stevexenios/TreePower/Misc Files/Presentation1.pptx

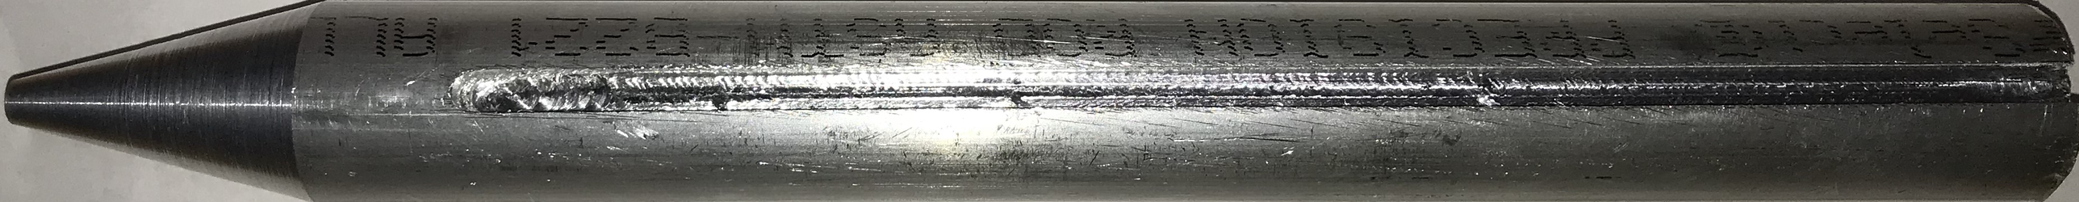
[picture p3: figure]
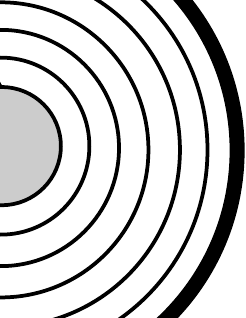
[picture p4: figure]

+
