stevexenios/TreePower/Misc Files/idea2.jpg

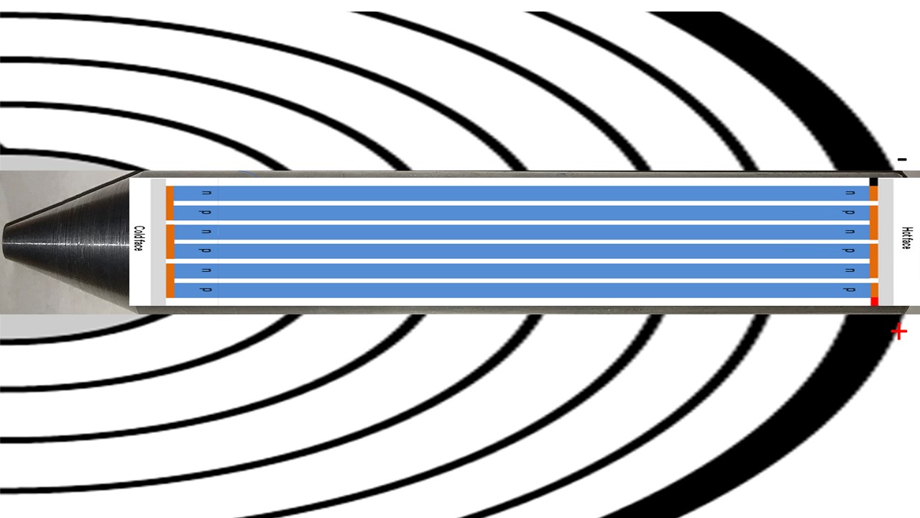
Misc Files/idea2.jpg
