stevexenios/TreePower/Misc Files/Projects.url.jpg

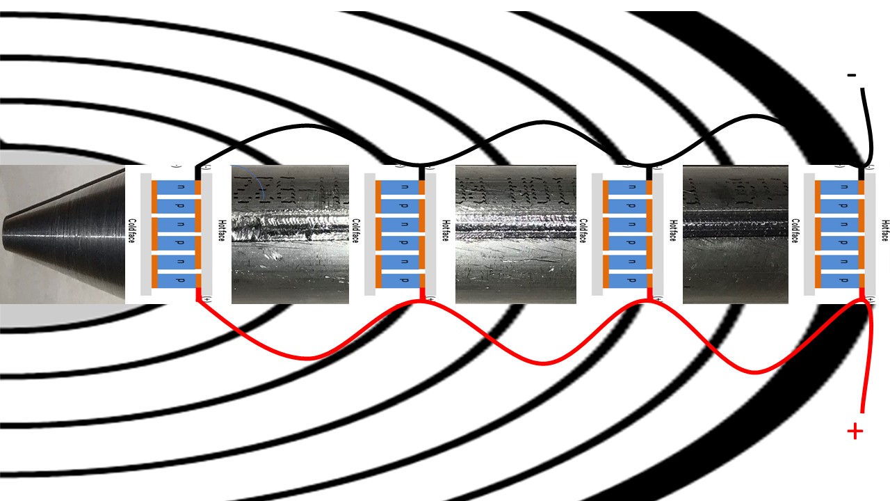
Misc Files/Projects.url.jpg
