stevexenios/TreePower/Pics/58335705034__45D44AAA-7878-4AA2-B2C0-D569AC8305C7.JPG

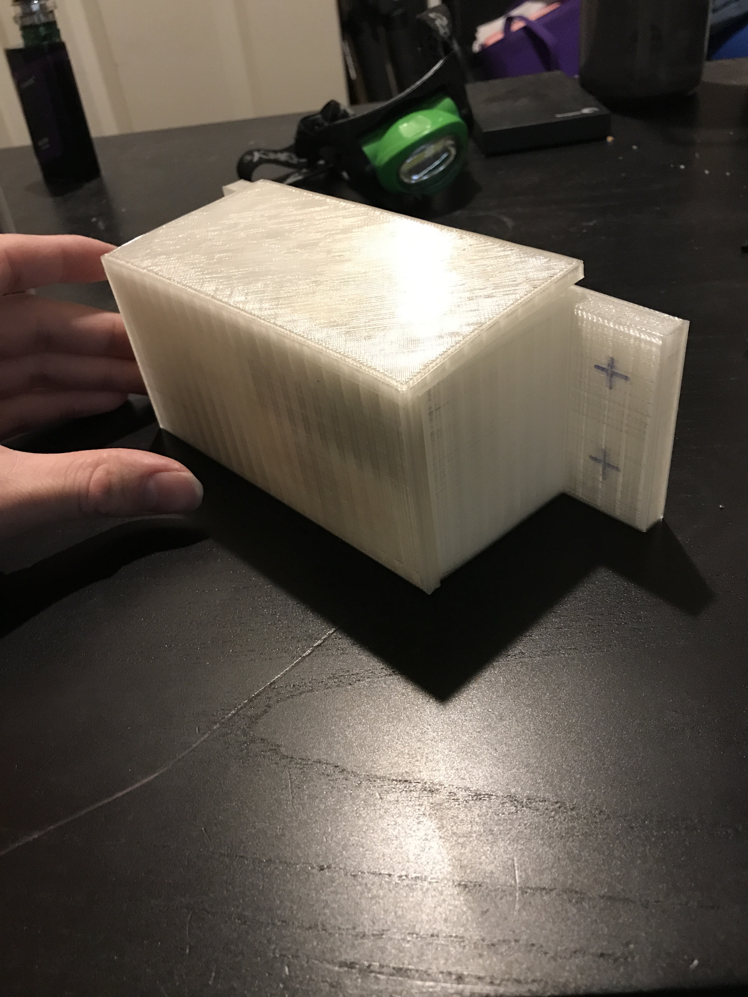
Pics/58335705034__45D44AAA-7878-4AA2-B2C0-D569AC8305C7.JPG
