stevexenios/TreePower/Pics/58335706449__F799D890-3CBF-4869-88B8-931E87948BA6.JPG

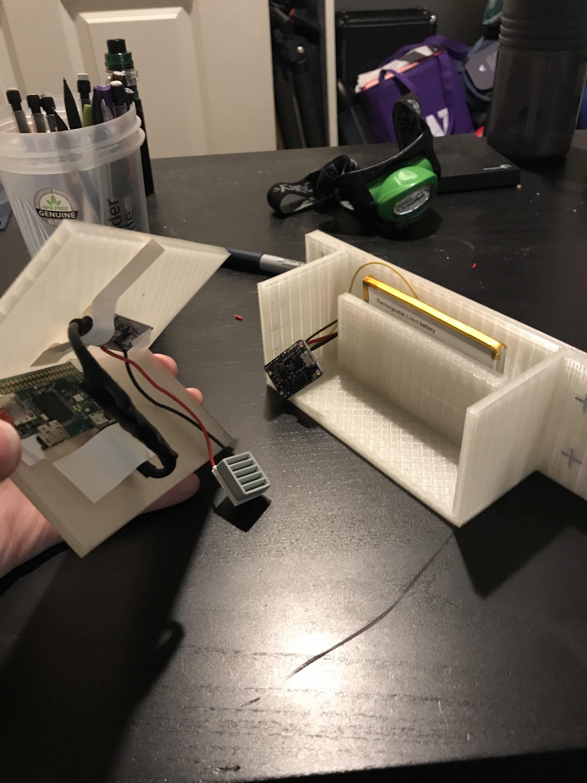
Pics/58335706449__F799D890-3CBF-4869-88B8-931E87948BA6.JPG
