stevexenios/TreePower/Pics/IMG_2349.jpg

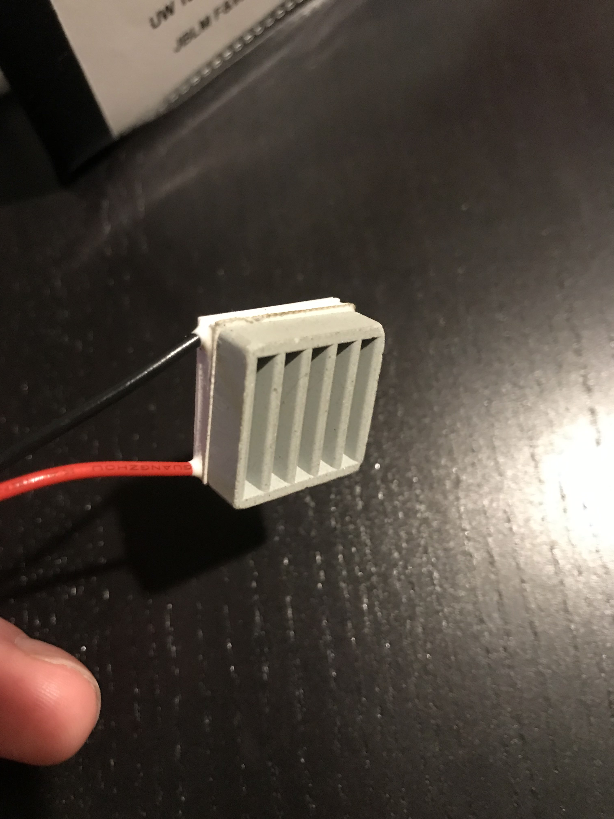
Pics/IMG_2349.jpg
