stevexenios/TreePower/Pics/IMG_2350.jpg

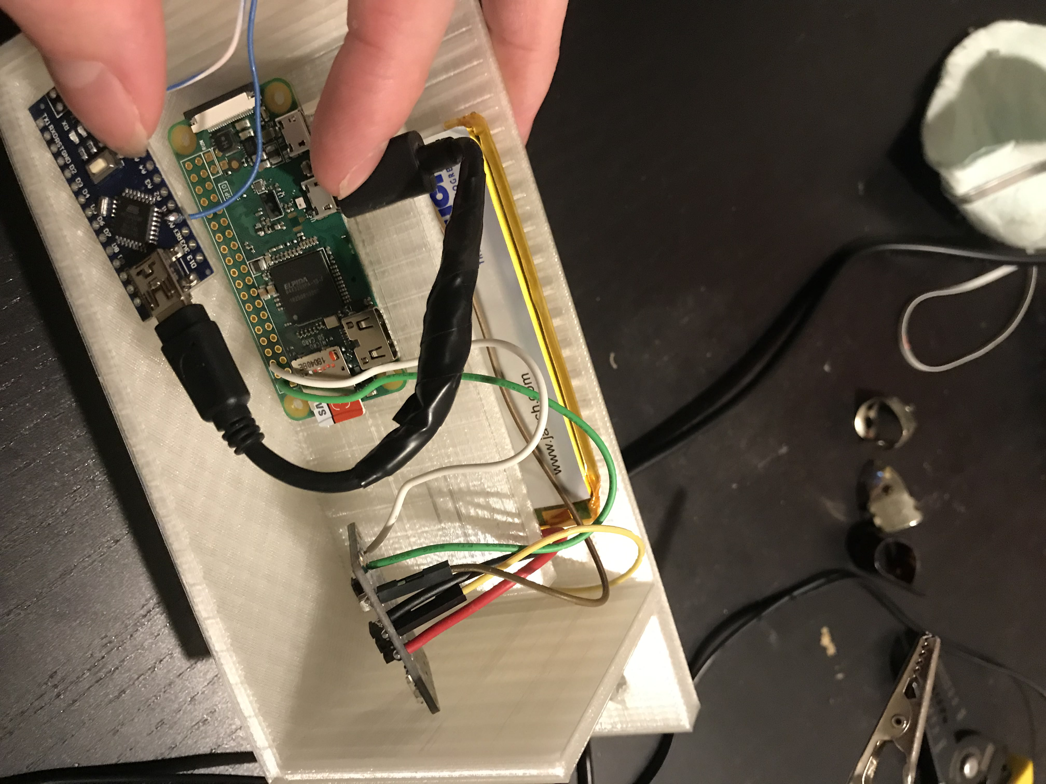
Pics/IMG_2350.jpg
