stevexenios/TreePower/Pics/IMG_2351.jpg

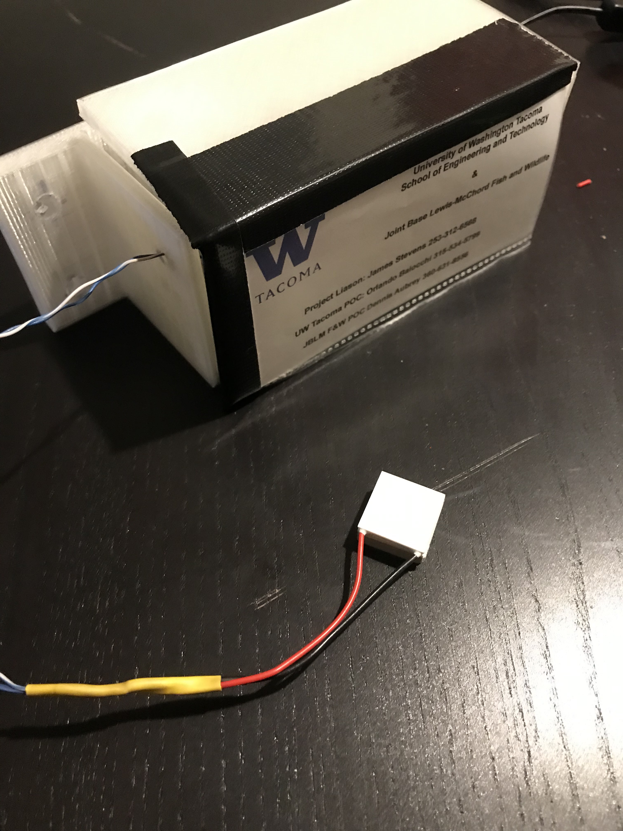
Pics/IMG_2351.jpg
