stevexenios/TreePower/Pics/IMG_2352.jpg

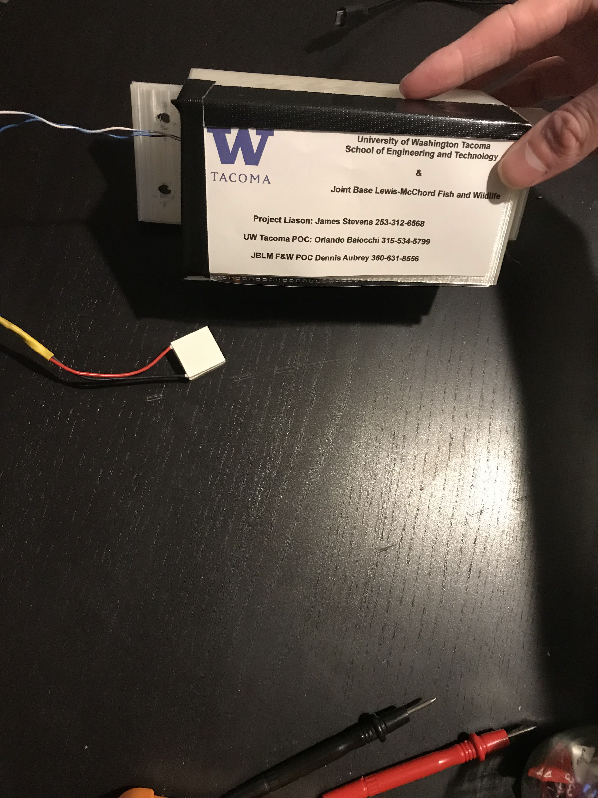
Pics/IMG_2352.jpg
