stevexenios/TreePower/Pics/IMG_2353.jpg

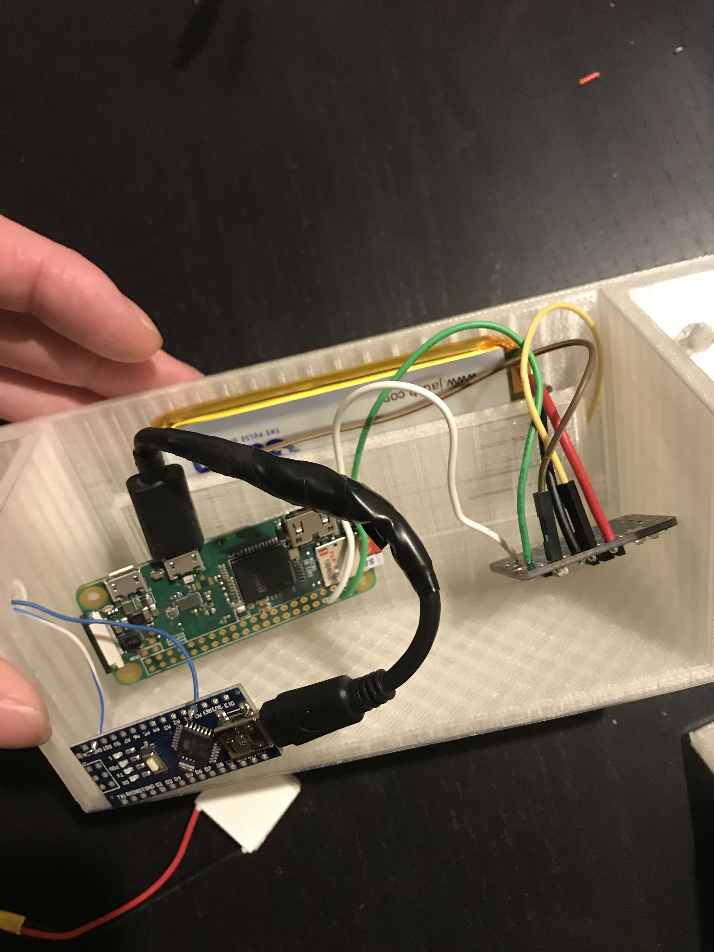
Pics/IMG_2353.jpg
