stevexenios/TreePower/Pics/IMG_2354.jpg

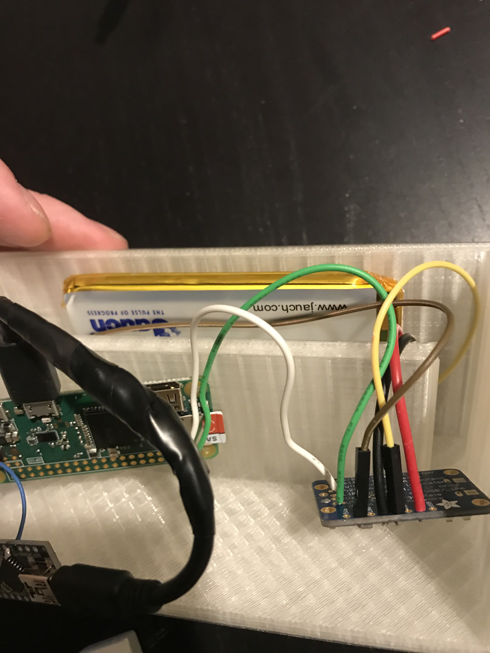
Pics/IMG_2354.jpg
