stevexenios/TreePower/Pics/IMG_2362.jpg

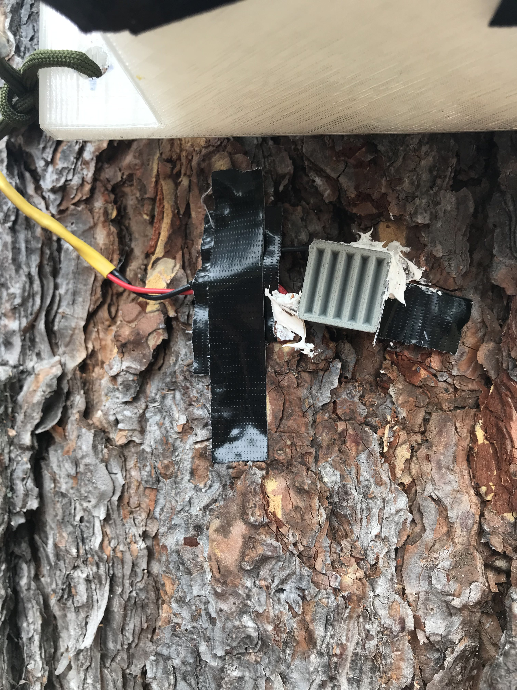
Pics/IMG_2362.jpg
