stevexenios/TreePower/Pics/IMG_2376.jpg

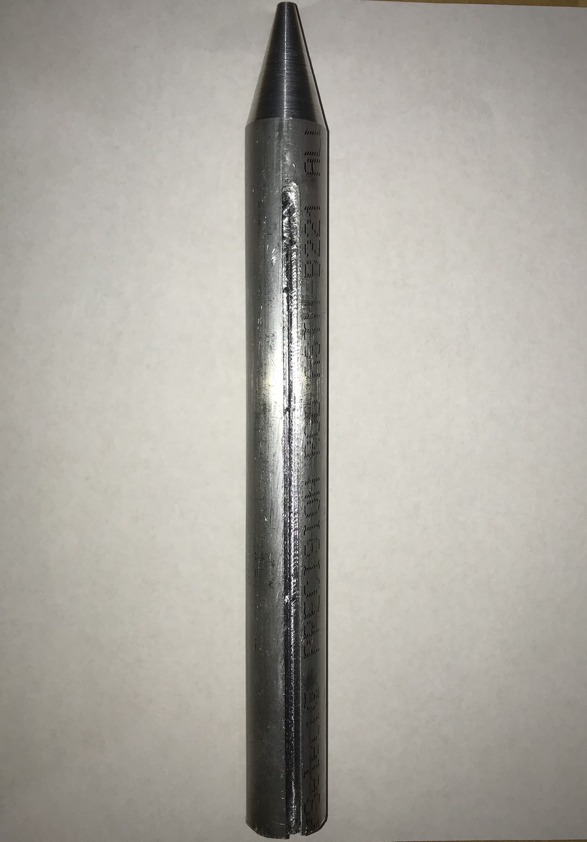
Pics/IMG_2376.jpg
