stevexenios/TreePower/Pics/IMG_2377.jpg

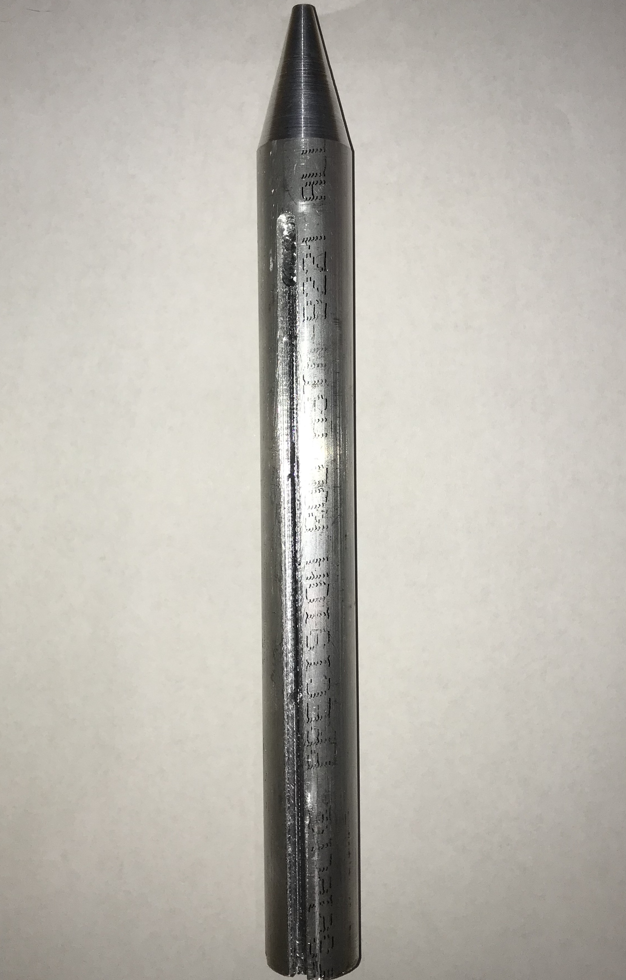
Pics/IMG_2377.jpg
