stevexenios/TreePower/Pics/IMG_2378.jpg

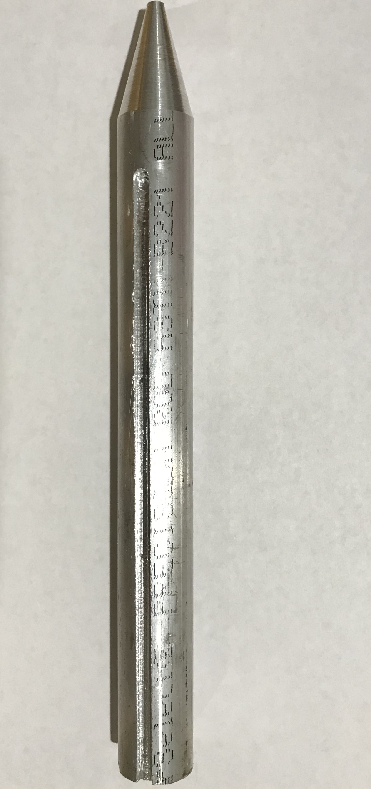
Pics/IMG_2378.jpg
