stevexenios/TreePower/Pics/IMG_2496.jpg

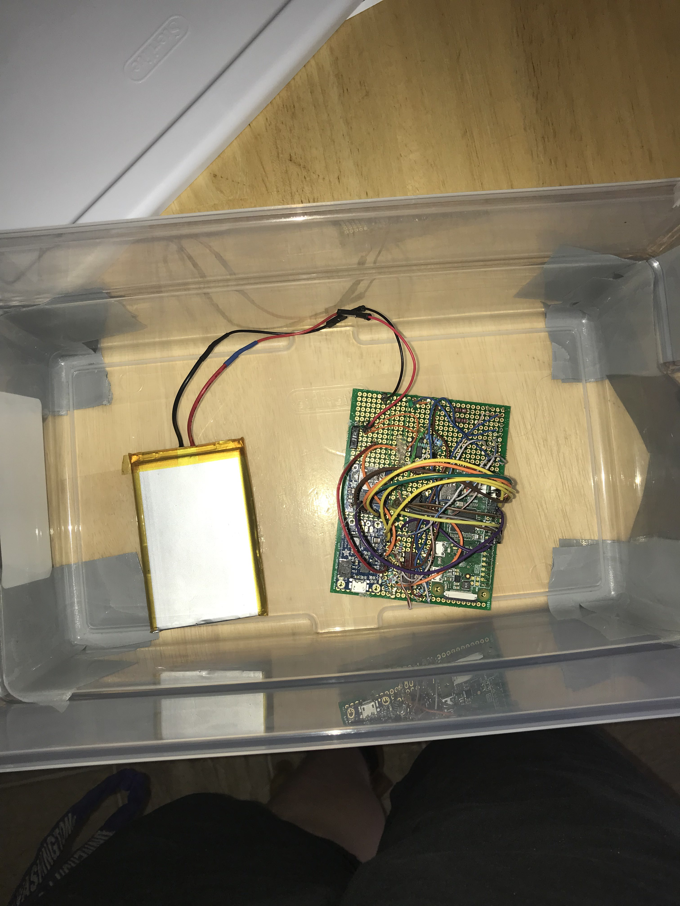
Pics/IMG_2496.jpg
