stevexenios/TreePower/Pics/IMG_2499.jpg

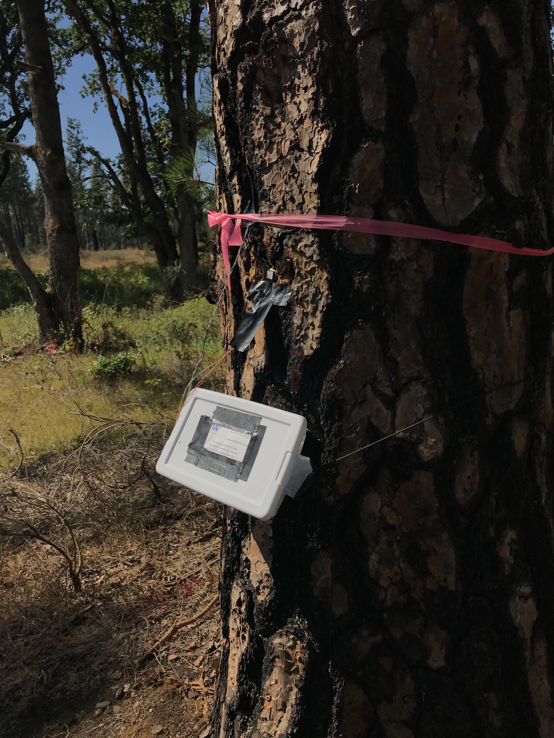
Pics/IMG_2499.jpg
