stevexenios/TreePower/Pics/IMG_2501.jpg

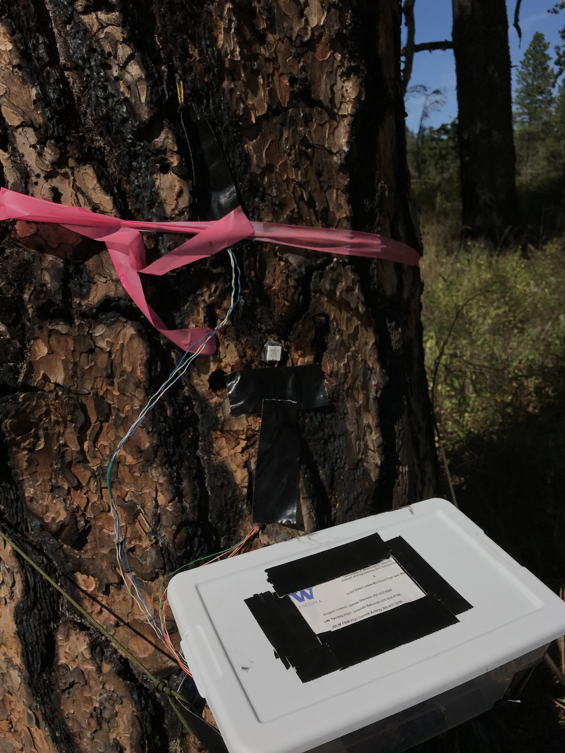
Pics/IMG_2501.jpg
