stevexenios/TreePower/Pics/IMG_2502.jpg

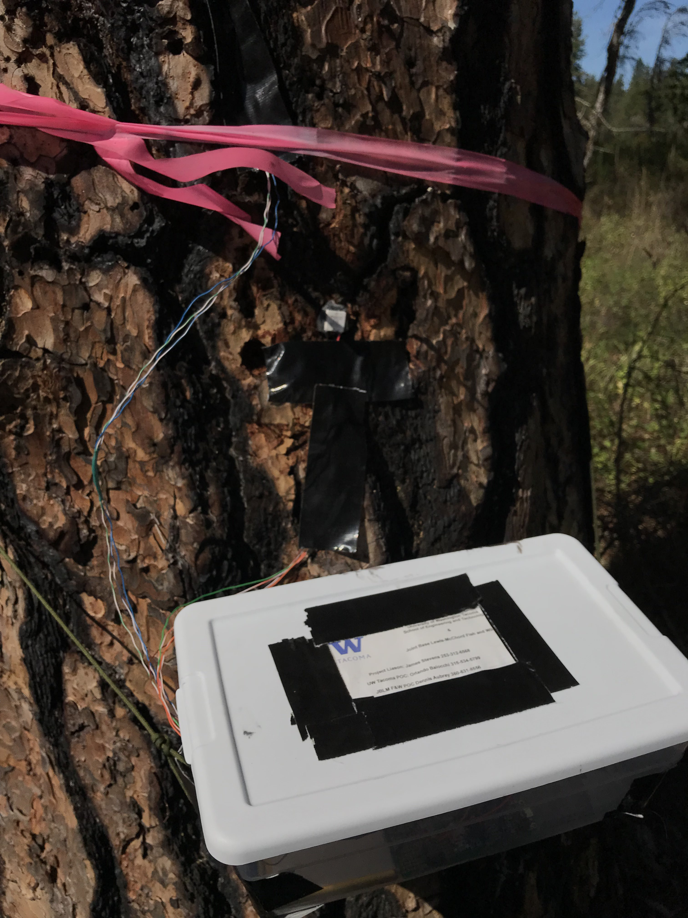
Pics/IMG_2502.jpg
