stevexenios/TreePower/Pics/IMG_2503.jpg

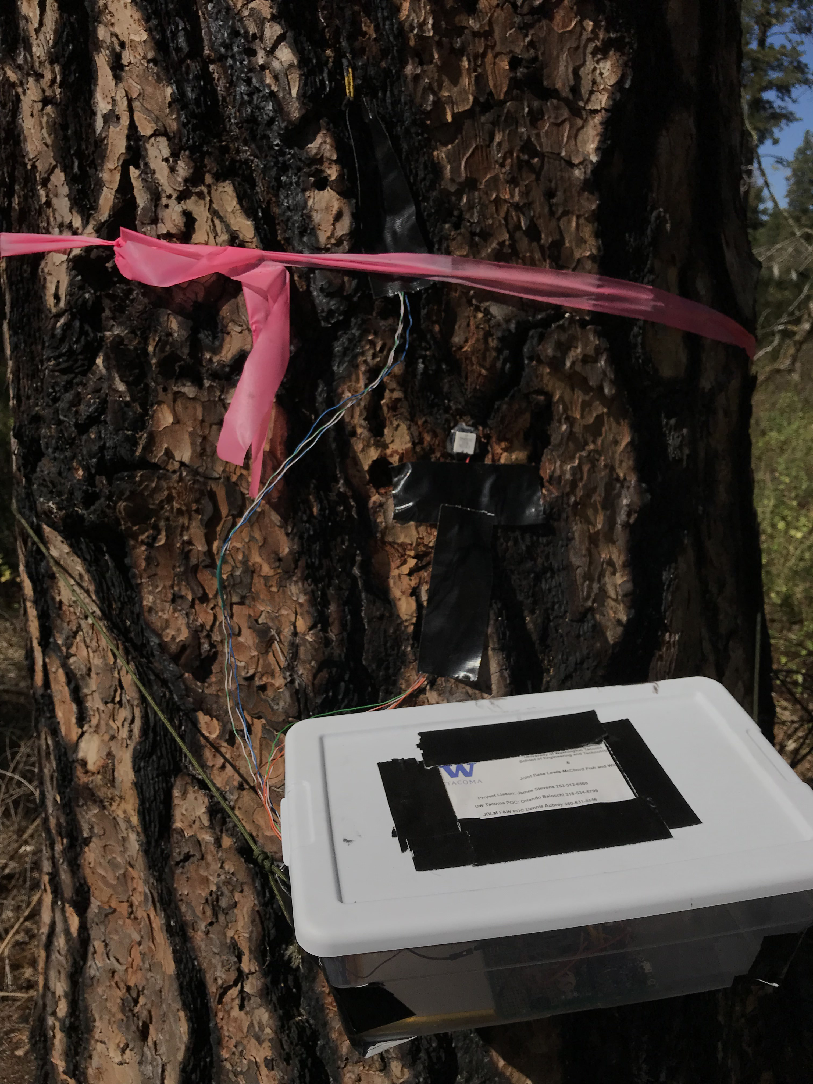
Pics/IMG_2503.jpg
