stevexenios/TreePower/Experiment2/Experiment 2 Parts List.xlsx

Name | Quantity | Price/Unit | Link to Purchase | Datasheet
47uF Cap | 3 | $0.45 | https://www.digikey.com/product-detail/en/UMV0J470MFD1TP/493-10307-1-ND/4312566 | http://nichicon-us.com/english/products/pdfs/e-umv.pdf
.012uF Cap | 3 | $0.32 | https://www.digikey.com/product-detail/en/kemet/C322C123K5R5TA/399-9799-ND/3726016 | https://www.digikey.com/product-detail/en/kemet/C322C123K5R5TA/399-9799-ND/3726016
24MOhm | 3 | $0.62 | https://www.digikey.com/product-detail/en/stackpole-electronics-inc/HVA05FA25M0/HVA05FA25M0CT-ND/6195867 | https://www.seielect.com/catalog/sei-hva.pdf
4MOhm | 3 | $0.54 | https://www.digikey.com/product-detail/en/vishay-bc-components/HVR3700004024FR500/PPCHF4.02MCT-ND/720047 | http://www.vishay.com/docs/30260/hvr2537.pdf
1Ohm | 12 | $0.21 | https://www.digikey.com/product-detail/en/vishay-bc-components/SFR25H0001008FR500/BC4398CT-ND/7351828 | http://www.vishay.com/docs/28722/sfr16s25.pdf
39kOhm | 12 | $0.10 | https://www.digikey.com/product-detail/en/stackpole-electronics-inc/RNF14FTD39K2/RNF14FTD39K2CT-ND/1975133 | https://www.seielect.com/catalog/sei-rnf_rnmf.pdf
40.2KOhm | 12 | $0.10 | https://www.digikey.com/product-detail/en/yageo/MFR-25FBF52-40K2/40.2KXBK-ND/13396
1kOhm | 24 | $0.10 | https://www.digikey.com/product-detail/en/stackpole-electronics-inc/RNF14FTD1K00/RNF14FTD1K00CT-ND/1975018 | https://www.seielect.com/catalog/sei-rnf_rnmf.pdf
7555 Timer | 3 | $0.83 | https://www.digikey.com/product-detail/en/renesas-electronics-america-inc/ICM7555IPAZ/ICM7555IPAZ-ND/821488 | https://www.renesas.com/us/en/www/doc/datasheet/icm7555-56.pdf
RTC Module | 1 | $4.95 | https://www.adafruit.com/product/3295 | https://learn.adafruit.com/adding-a-real-time-clock-to-raspberry-pi?view=all
LM35 (Better Package) | 15 | $2.01 | https://www.digikey.com/product-detail/en/texas-instruments/LM35DZ-LFT1/296-35151-1-ND/3640792 | http://www.ti.com/general/docs/suppproductinfo.tsp?distId=10
15mm TEG | 2 | $15.80 | https://www.digikey.com/product-detail/en/CP60133/102-1672-ND/1747364 | https://www.cui.com/product/resource/cp60.pdf
8 Channel ADC | 2 | $3.75 | https://www.adafruit.com/product/856 | https://learn.adafruit.com/mcp3008-spi-adc/python-circuitpython
MAX44241 OpAmp | 8 | $1.69 | https://www.digikey.com/product-detail/en/MAX44241AUA%2b/MAX44241AUA%2b-ND/4438073?so=59708903 | https://datasheets.maximintegrated.com/en/ds/MAX44241-MAX44246.pdf
Adapter | 8 | $3.19 | https://www.digikey.com/product-detail/en/PA0032/PA0032-ND/5014735?so=59708903 | http://www.chipquik.com/datasheets/PA0032.pdf
Veroboard | 1 | $10.49 | https://www.digikey.com/product-detail/en/chip-quik-inc/SBBTH3040-1/SBBTH3040-1-ND/5978254 | http://www.chipquik.com/datasheets/SBBTH3040-1.pdf
Total |  | $139.33
66uA | 3.7V
