stevexenios/TreePower/Misc Files/base_thermo v2.step

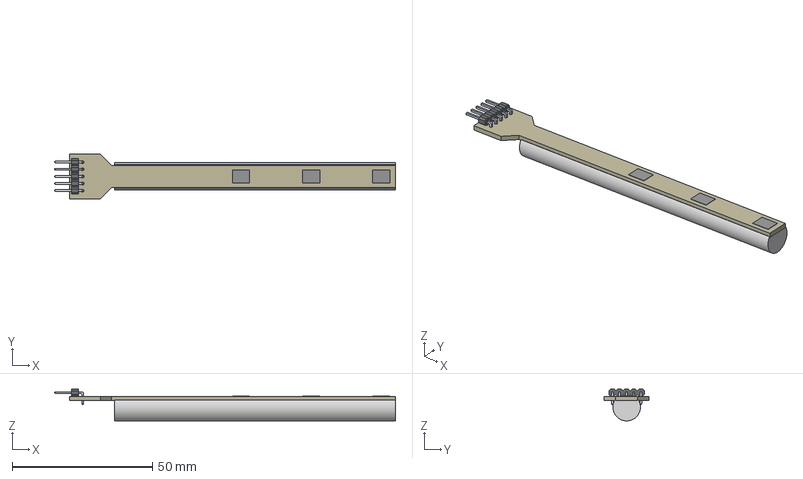
[picture p40: CAD file, 2019-07-12]
Misc Files/base_thermo v2.step
121.4 x 16.0 x 11.3 mm
Board
LM35DM x 3
1X05/90
