stevexenios/TreePower/Experiment1/Exp1.xlsx

Sheet: Sheet1
Date and Time | TEG Voltage (Open Circuit) | Average Voltage(mV) | Voltage(mV)
2019-07-02 14:49 | 0.00mV | 0 | 0
2019-07-02 14:59 | 0.00mV | 0 | 0
2019-07-02 15:09 | 0.00mV | 0 | 0
2019-07-02 15:19 | 0.00mV | 0 | 0
2019-07-02 15:29 | 0.00mV | 0 | 0
2019-07-02 15:39 | 0.00mV | 0 | 0
2019-07-02 15:49 | 0.00mV | 0 | 0
2019-07-02 15:59 | 0.00mV | 0 | 0
2019-07-02 16:09 | 0.00mV | 0 | 0
2019-07-02 16:19 | 0.00mV | 0 | 0
2019-07-02 16:29 | 0.00mV | 0 | 0
2019-07-02 16:39 | 0.00mV | 0 | 0
2019-07-02 16:49 | 0.00mV | 0 | 0
2019-07-02 16:59 | 0.00mV | 0 | 0
2019-07-02 17:09 | 0.00mV | 0 | 0
2019-07-02 17:19 | 0.00mV | 0 | 0
2019-07-02 17:29 | 0.00mV | 0 | 0
2019-07-02 17:39 | 0.00mV | 0 | 0
2019-07-02 17:49 | 0.00mV | 0 | 0
2019-07-02 17:59 | 0.00mV | 0 | 0
2019-07-02 18:09 | 0.00mV | 0 | 0
2019-07-02 18:19 | 0.00mV | 0 | 0
2019-07-02 18:29 | 0.00mV | 0 | 0
2019-07-02 18:39 | 0.00mV | 0 | 0
2019-07-02 18:49 | 0.00mV | 0 | 0
2019-07-02 18:59 | 0.00mV | 0 | 0
2019-07-02 19:09 | 0.00mV | 0 | 0
2019-07-02 19:19 | 0.00mV | 0 | 0
2019-07-02 19:29 | 0.00mV | 0 | 0
2019-07-02 19:39 | 0.00mV | 0 | 0
2019-07-02 19:49 | 0.00mV | 0 | 0
2019-07-02 20:00 | 0.00mV | 0 | 0
2019-07-02 20:10 | 0.00mV | 0 | 0
2019-07-02 20:20 | 0.00mV | 0 | 0
2019-07-02 20:30 | 0.00mV | 0 | 0
2019-07-02 20:40 | 0.00mV | 0 | 0
2019-07-02 20:50 | 0.00mV | 0 | 0
2019-07-02 21:00 | 0.00mV | 0 | 0
2019-07-02 21:10 | 0.00mV | 0 | 0
2019-07-02 21:20 | 0.00mV | 0 | 0
2019-07-02 21:30 | 0.00mV | 0 | 0
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
2019-07-03 12:32 | 0.00mV | 0 | 0
2019-07-03 12:42 | 0.00mV | 0 | 0
2019-07-03 12:52 | 0.00mV | 0 | 0
2019-07-03 13:02 | 0.00mV | 0 | 0
2019-07-03 13:12 | 0.00mV | 0 | 0
2019-07-03 13:22 | 0.00mV | 0 | 0
2019-07-03 13:32 | 0.00mV | 0 | 0
2019-07-03 13:42 | 0.00mV | 0 | 0

Sheet: Sheet2
Time | TEG Voltage (Open Circuit) | Ambient Temperature
2019-07-06 12:17 | 0.00mV | 64 |  | 0
2019-07-06 12:22 | 0.00mV | 64 |  | 0
2019-07-06 12:27 | 0.00mV |  | #N/A | 0
2019-07-06 12:32 | 0.00mV |  | #N/A | 0
2019-07-06 12:53 | 0.00mV | 64 |  | 0
2019-07-06 12:58 | 0.00mV | 65 |  | 0
2019-07-06 13:08 | 0.00mV | 64 |  | 0
2019-07-06 13:58 | 0.00mV | 65 | 18.33°C | 0
2019-07-06 14:48 | 0.00mV |  | #N/A | 0
2019-07-06 14:52 | 0.00mV |  | #N/A | 0
2019-07-06 14:58 | 0.00mV | 66 | 18.89°C | 0
2019-07-06 15:22 | 0.00mV |  | #N/A | 0
2019-07-06 15:22 | 0.00mV |  | #N/A | 0
2019-07-06 15:27 | 0.00mV |  | #N/A | 0
2019-07-06 15:27 | 0.00mV |  | #N/A | 0
2019-07-06 15:32 | 0.00mV |  | #N/A | 0
2019-07-06 15:32 | 0.00mV |  | #N/A | 0
2019-07-06 15:37 | 0.00mV |  | #N/A | 0
2019-07-06 15:37 | 0.00mV |  | #N/A | 0
2019-07-06 15:42 | 0.00mV |  | #N/A | 0
2019-07-06 15:42 | 0.00mV |  | #N/A | 0
2019-07-06 15:47 | 0.00mV |  | #N/A | 0
2019-07-06 15:47 | 0.00mV |  | #N/A | 0
2019-07-06 15:52 | 0.00mV |  | #N/A | 0
2019-07-06 15:52 | 0.00mV |  | #N/A | 0
2019-07-06 15:57 | 0.00mV |  | #N/A | 0
2019-07-06 15:57 | 0.00mV |  | #N/A | 0
2019-07-06 15:58 | 0.00mV | 67 | 19.44°C | 0
2019-07-06 16:02 | 0.00mV |  | #N/A | 0
2019-07-06 16:02 | 0.00mV |  | #N/A | 0
2019-07-06 16:07 | 0.00mV |  | #N/A | 0
2019-07-06 16:07 | 0.00mV |  | #N/A | 0
2019-07-06 16:12 | 0.00mV |  | #N/A | 0
2019-07-06 16:12 | 0.00mV |  | #N/A | 0
2019-07-06 16:17 | 0.00mV |  | #N/A | 0
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
2019-07-07 11:11 | 0.00mV |  | #N/A | 0
2019-07-07 11:16 | 0.00mV |  | #N/A | 0
2019-07-07 11:16 | 0.00mV |  | #N/A | 0
2019-07-07 11:21 | 0.00mV |  | #N/A | 0
2019-07-07 11:21 | 0.00mV |  | #N/A | 0
2019-07-07 11:26 | 0.00mV |  | #N/A | 0
2019-07-07 11:26 | 0.00mV |  | #N/A | 0
