stevexenios/TreePower/Experiment2/Exp2.xlsx

Sheet: Exp2
T-Rod | T-Ambient | V(-) | V(+) | Ambient-24.7 | Simulated Voltage | Power(-) | Power(+) | Time | Simulated Voltage | Positive mV/C | Negative mV/C
27.393 °C | 41.250 °C | 0.000mV | 2.141mV | 16.550 °C | 4.1375 | 0.000uW | 4.584uW | 2019-08-13 15:38 | 3.310mV | 0.2 | 0.2 | 1.169mV | -3.619 | 6.252344629e-05 |  | 0.0001 | 0.4 | 0.0005607421462 | 0.0001 | 0.0015 | 1.066152056
27.393 °C | 41.250 °C | 0.000mV | 2.141mV | 16.550 °C | 4.1375 | 0.000uW | 4.584uW | 2019-08-13 15:38 | 3.310mV |  |  | 1.169mV | -3.5834 | 6.252344629e-05 |  | 0.0001
27.393 °C | 40.928 °C | 0.000mV | 2.141mV | 16.228 °C | 4.057 | 0.000uW | 4.584uW | 2019-08-13 15:38 | 3.246mV |  |  | 1.105mV | -3.5544 | 6.252344629e-05 |  | 0.0001
27.393 °C | 41.250 °C | 0.000mV | 2.141mV | 16.550 °C | 4.1375 | 0.000uW | 4.584uW | 2019-08-13 15:38 | 3.310mV |  |  | 1.169mV | -3.519 | 0.0001875703389 |  | 0.0001
27.393 °C | 41.250 °C | 0.000mV | 2.049mV | 16.550 °C | 4.1375 | 0.000uW | 4.198uW | 2019-08-13 15:38 | 3.310mV |  |  | 1.261mV | -3.5122 | 0.0001250468926 |  | 0.0001
27.715 °C | 41.572 °C | 0.000mV | 2.141mV | 16.872 °C | 4.218 | 0.000uW | 4.584uW | 2019-08-13 15:38 | 3.374mV |  |  | 1.233mV | -3.4834 | 6.252344629e-05 |  | 0.0001
27.715 °C | 41.250 °C | 0.000mV | 2.141mV | 16.550 °C | 4.1375 | 0.000uW | 4.584uW | 2019-08-13 15:38 | 3.310mV |  |  | 1.169mV | -3.4768 | 6.252344629e-05 |  | 0.0001
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
23.525 °C | 31.904 °C | 0.000mV | 1.701mV | 7.204 °C | 1.801 | 0.000uW | 2.893uW | 2019-08-13 17:26 | 1.441mV |  |  | -0.260mV | -0.4326 | 0.003563836439 |  | 0.0009323344736
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
