stevexenios/TreePower/Experiment1/Test 1 Results.xlsx

Sheet: Sheet2
Date | Time | Voltage(mV) | Average Voltage(mV) | Voltage(mV)
2019-07-02 | 14:39:07 | 0 | 0
2019-07-02 | 14:44:08 | 0 | 0
2019-07-02 | 14:49:09 | 0 | 0 | 0
2019-07-02 | 14:54:10 | 0 | 0
2019-07-02 | 14:59:11 | 0 | 0 | 0
2019-07-02 | 15:04:11 | 0 | 0
2019-07-02 | 15:09:12 | 0 | 0 | 0
2019-07-02 | 15:14:13 | 0 | 0
2019-07-02 | 15:19:13 | 0 | 0 | 0
2019-07-02 | 15:24:15 | 0 | 0
2019-07-02 | 15:29:16 | 0 | 0 | 0
2019-07-02 | 15:34:16 | 0 | 0
2019-07-02 | 15:39:17 | 0 | 0 | 0
2019-07-02 | 15:44:18 | 0 | 0
2019-07-02 | 15:49:18 | 0 | 0 | 0
2019-07-02 | 15:54:20 | 0 | 0
2019-07-02 | 15:59:21 | 0 | 0 | 0
2019-07-02 | 16:04:21 | 0 | 0
2019-07-02 | 16:09:22 | 0 | 0 | 0
2019-07-02 | 16:14:23 | 0 | 0
2019-07-02 | 16:19:23 | 0 | 0 | 0
2019-07-02 | 16:24:25 | 0 | 0
2019-07-02 | 16:29:25 | 0 | 0 | 0
2019-07-02 | 16:34:26 | 0 | 0
2019-07-02 | 16:39:27 | 0 | 0 | 0
2019-07-02 | 16:44:27 | 0 | 0
2019-07-02 | 16:49:28 | 0 | 0 | 0
2019-07-02 | 16:54:30 | 0 | 0
2019-07-02 | 16:59:30 | 0 | 0 | 0
2019-07-02 | 17:04:31 | 0 | 0
2019-07-02 | 17:09:32 | 0 | 0 | 0
2019-07-02 | 17:14:32 | 0 | 0
2019-07-02 | 17:19:33 | 0 | 0 | 0
2019-07-02 | 17:24:35 | 0 | 0
2019-07-02 | 17:29:35 | 0 | 0 | 0
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
