stevexenios/TreePower/Experiment2/AluminumRod.JPG

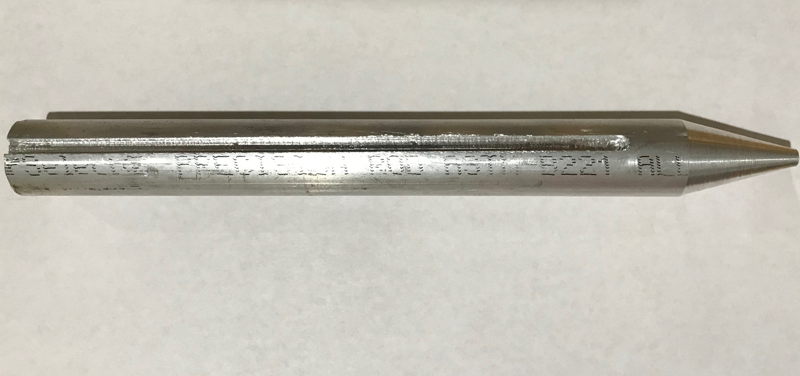
Experiment2/AluminumRod.JPG
