stevexenios/TreePower/Experiment2/7555LTSpice.asc

C1: cap; 47µ
C2: cap; .01µF
D1: diode; 1N914
R1: res; 24Meg
R2: res; 4Meg
U1: NE555
V1: voltage; 3.7
Named nets: 0, Vin
.tran 18000 startup
