stevexenios/TreePower/Experiment2/Schematics/Sense1.sch

## KiCad design Experiment2/Schematics/Sense1.sch (2019-09-02)

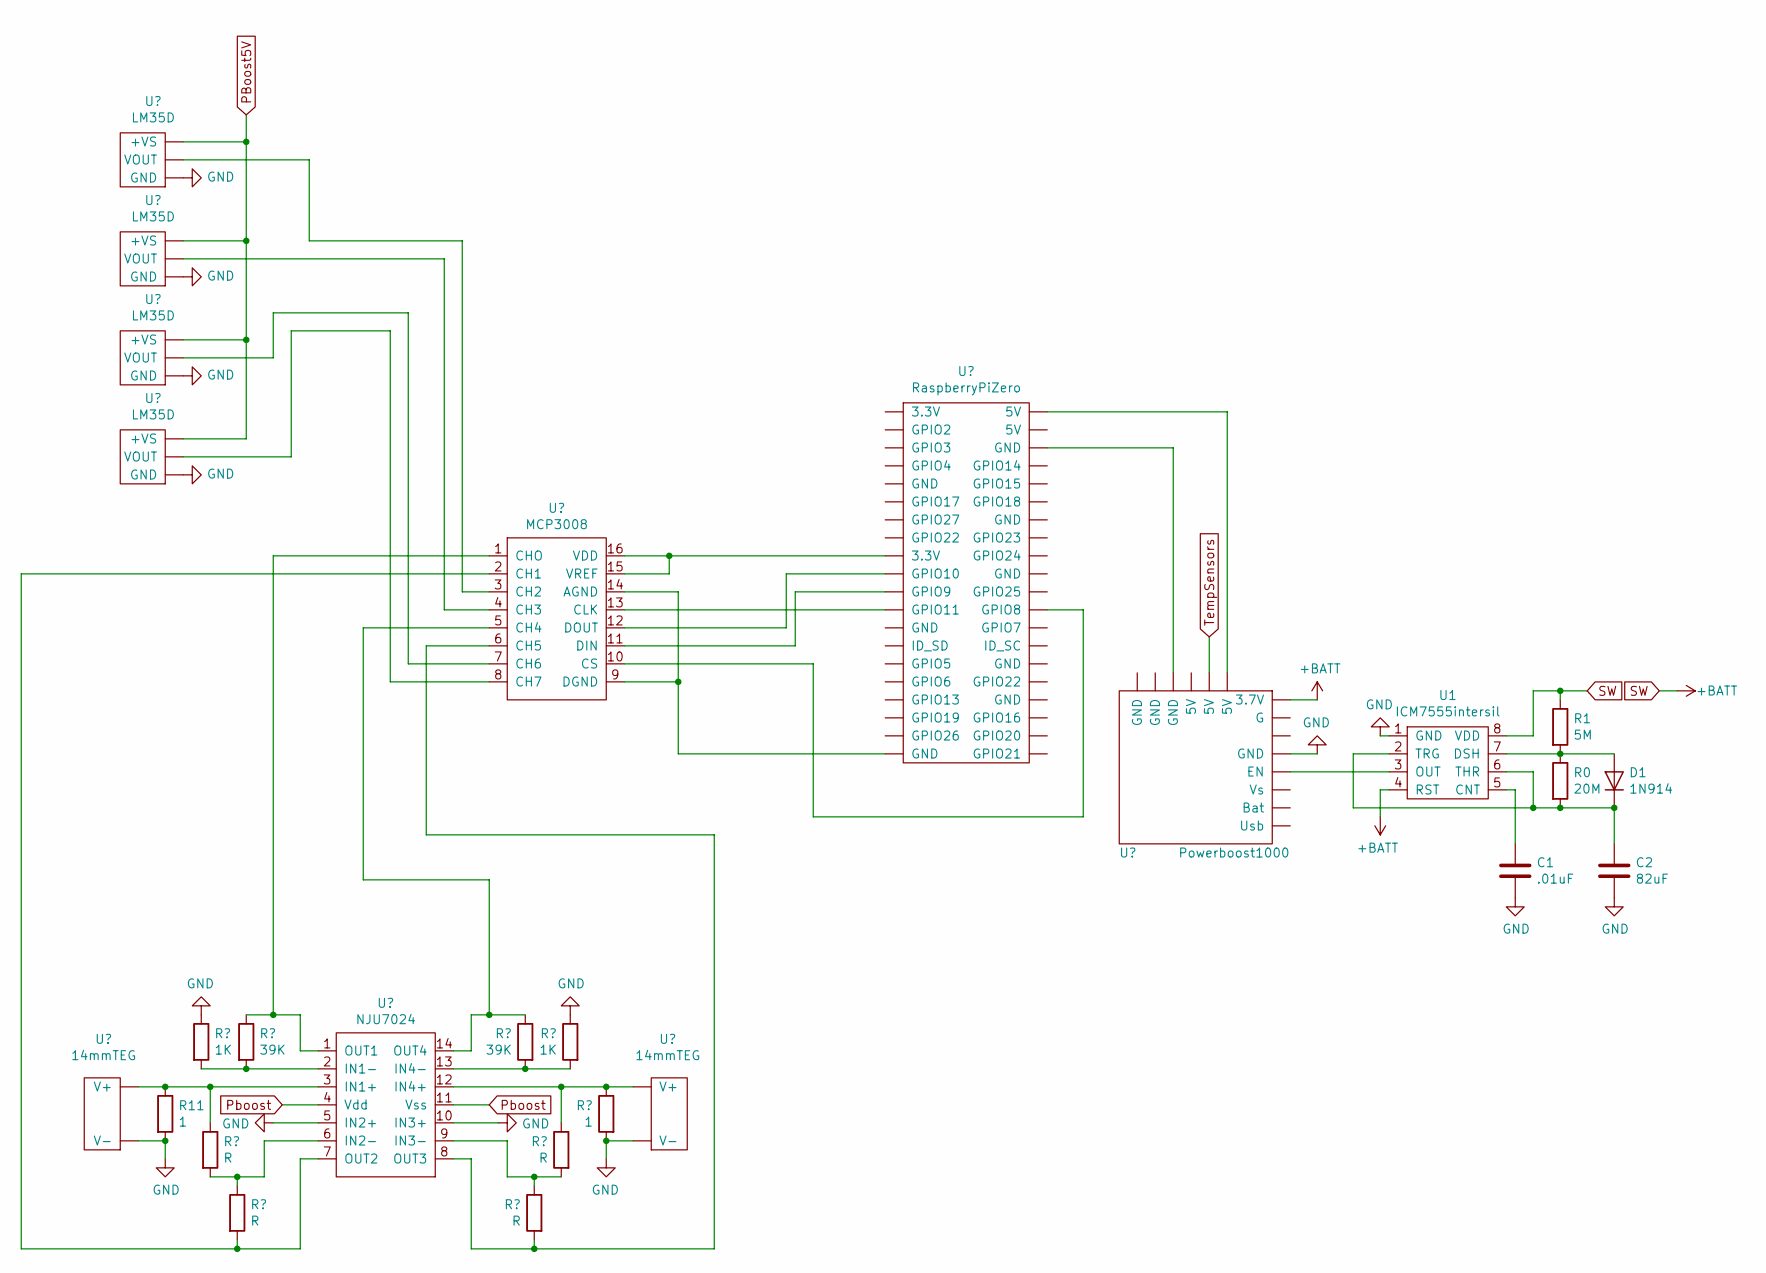
[picture p42: schematic Sense1.sch]

Parts:
C1: .01uF; C_Rect_L7.0mm_W4.5mm_P5.00mm
C2: 82uF; CP_Radial_D5.0mm_P2.50mm
D1: 1N914; D_DO-35_SOD27_P7.62mm_Horizontal
R0: 20M; R_Axial_DIN0309_L9.0mm_D3.2mm_P12.70mm_Horizontal
R1: 5M; R_Axial_DIN0309_L9.0mm_D3.2mm_P12.70mm_Horizontal
R11: 1
U1: ICM7555intersil

Connections:
+BATT: R1.1, U1.4 (RST), U1.8 (VDD)
GND: C1.2, C2.2, R11.2, U1.1 (GND)
unnamed: C1.1, U1.5 (CNT)
unnamed: C2.1, D1.1 (K), R0.2, U1.2 (TRG), U1.6 (THR)
unnamed: D1.2 (A), R0.1, R1.2, U1.7 (DSH)
