stevexenios/TreePower/Experiment2/Schematics/TreePower2.sch

## KiCad design Experiment2/Schematics/TreePower2.sch (2019-09-02)

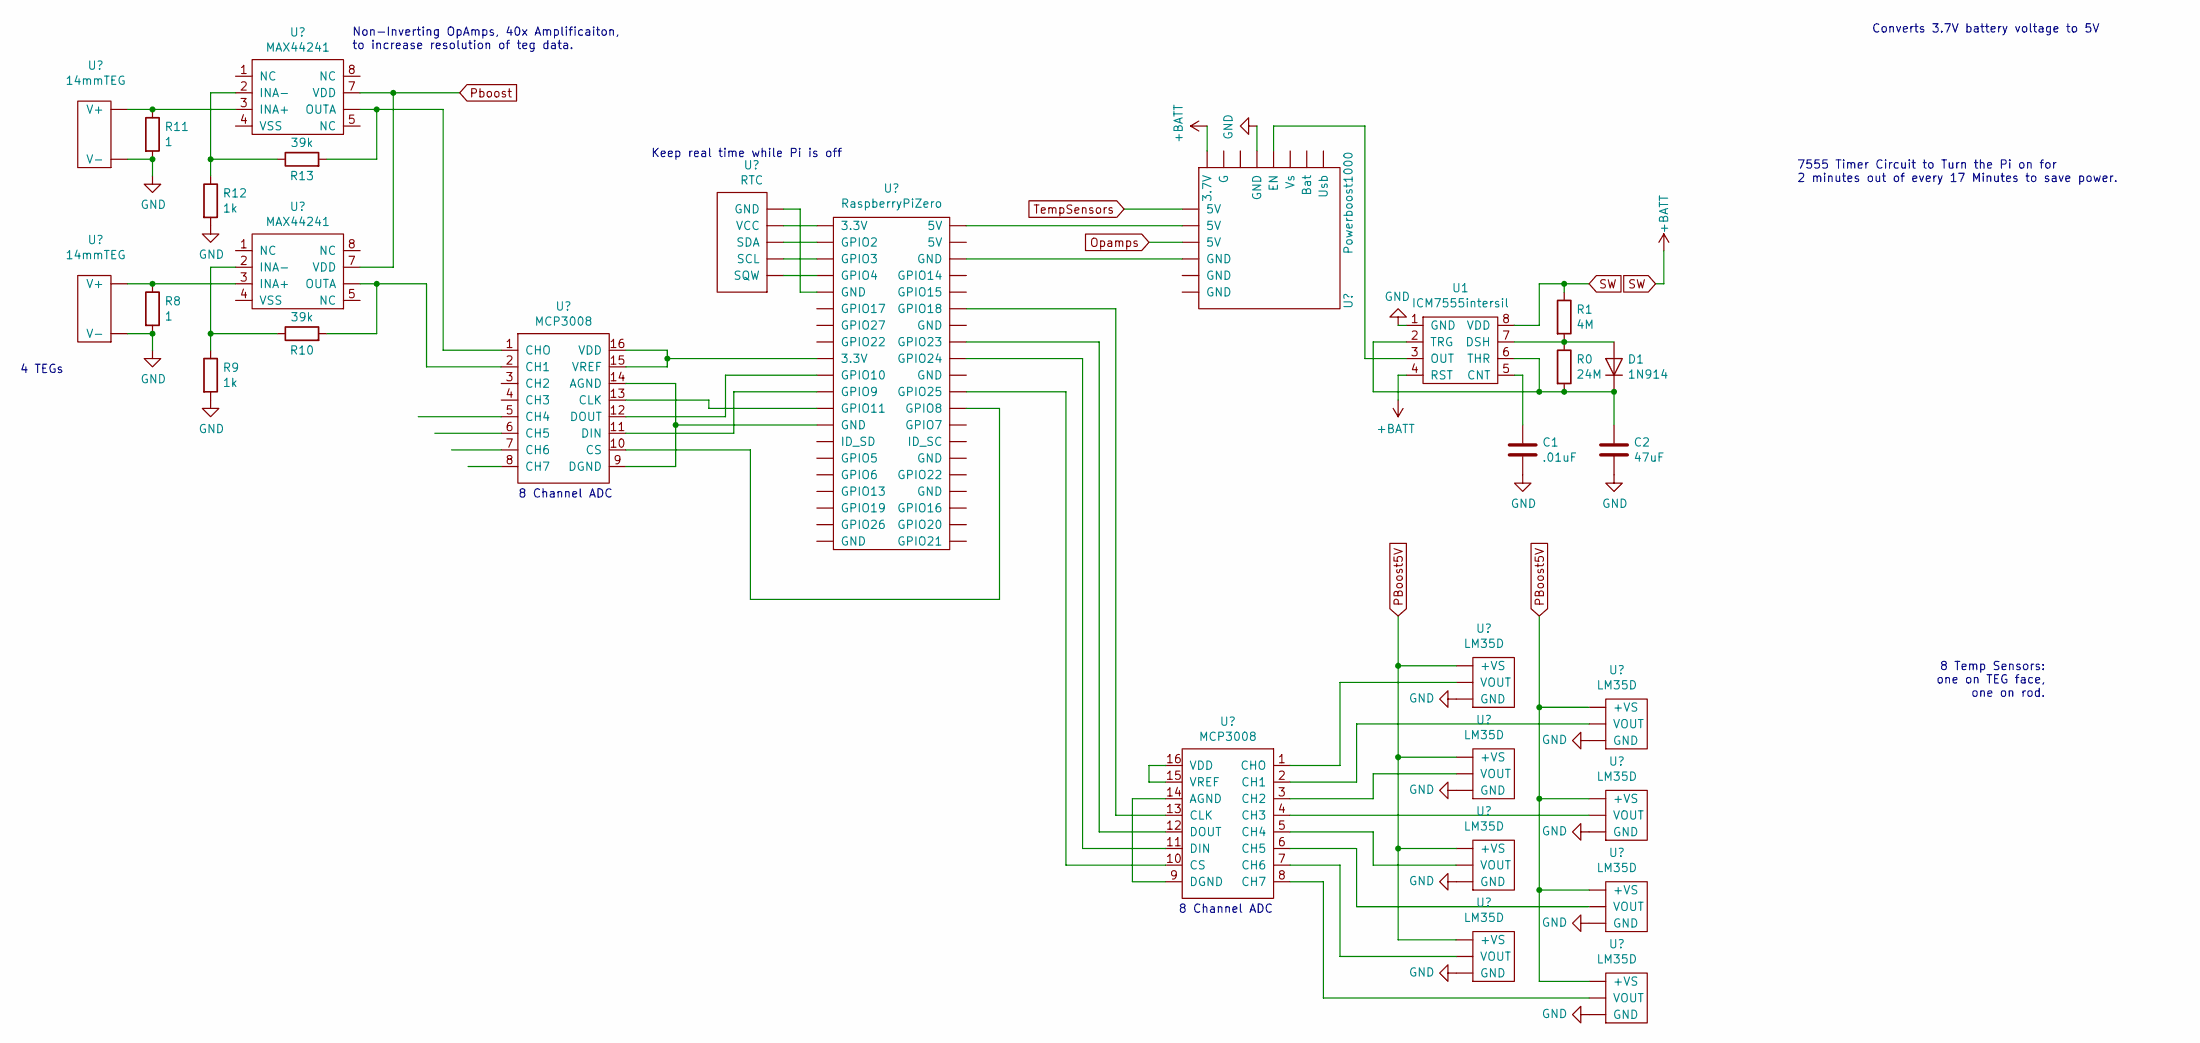
[picture p43: schematic TreePower2.sch]

Parts:
C1: .01uF; C_Rect_L7.0mm_W4.5mm_P5.00mm
C2: 47uF; CP_Radial_D5.0mm_P2.50mm
D1: 1N914; D_DO-35_SOD27_P7.62mm_Horizontal
R0: 24M; R_Axial_DIN0309_L9.0mm_D3.2mm_P12.70mm_Horizontal
R1: 4M; R_Axial_DIN0309_L9.0mm_D3.2mm_P12.70mm_Horizontal
R8, R11: 1
R9, R12: 1k
R10, R13: 39k
U1: ICM7555intersil

Connections:
+BATT: R1.1, U1.4 (RST), U1.8 (VDD)
GND: C1.2, C2.2, R8.2, R9.2, R11.2, R12.2, U1.1 (GND)
unnamed: C1.1, U1.5 (CNT)
unnamed: C2.1, D1.1 (K), R0.2, U1.2 (TRG), U1.6 (THR)
unnamed: D1.2 (A), R0.1, R1.2, U1.7 (DSH)
unnamed: R9.1, R10.1
unnamed: R12.1, R13.1

Notes on the sheet:
Keep real time while Pi is off
8 Channel ADC
4 TEGs
Non-Inverting OpAmps, 40x Amplificaiton, to increase resolution of teg data.
7555 Timer Circuit to Turn the Pi on for 2 minutes out of every 17 Minutes to save power.
Converts 3.7V battery voltage to 5V
8 Temp Sensors: one on TEG face, one on rod.
