stevexenios/TreePower/(commit log)

2019-06-30 Create writevolt.py
    Saves voltage data from arduino on pi
2019-07-06 arduino code
2019-07-12 Schematic for the 2nd Experiment
2019-07-12 misc files
    [base_thermo v2.step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]
2019-09-02 Missing Files
    [Sense1.kicad_pcb, Sense1.sch, TreePower2.sch]
