stevexenios/TreePower/Pics/IMG_2355.jpg

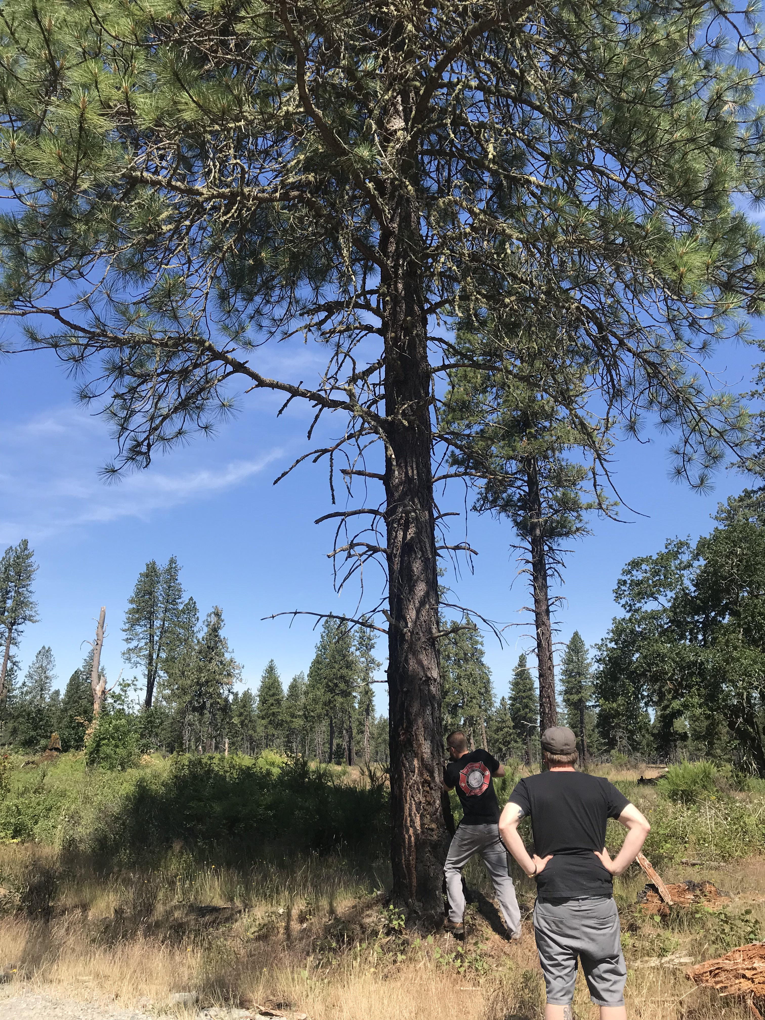
Pics/IMG_2355.jpg
