stevexenios/TreePower/Pics/IMG_2356.jpg

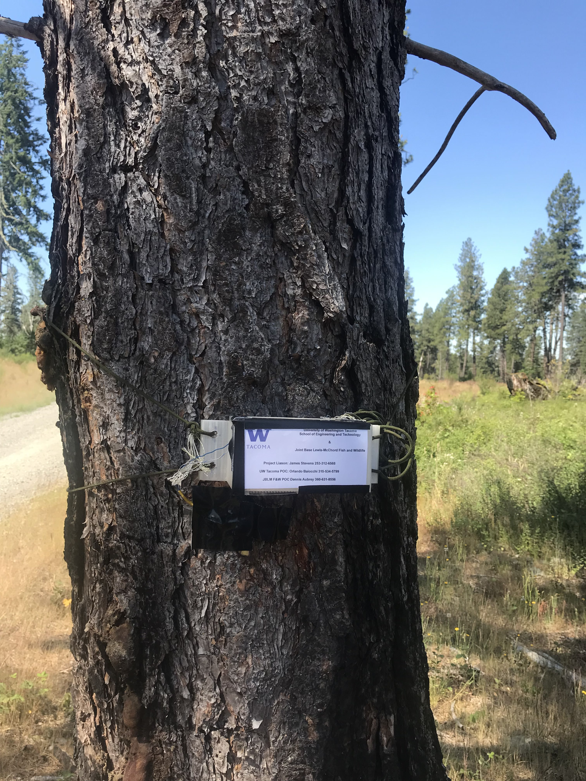
Pics/IMG_2356.jpg
