stevexenios/TreePower/Pics/IMG_2359.jpg

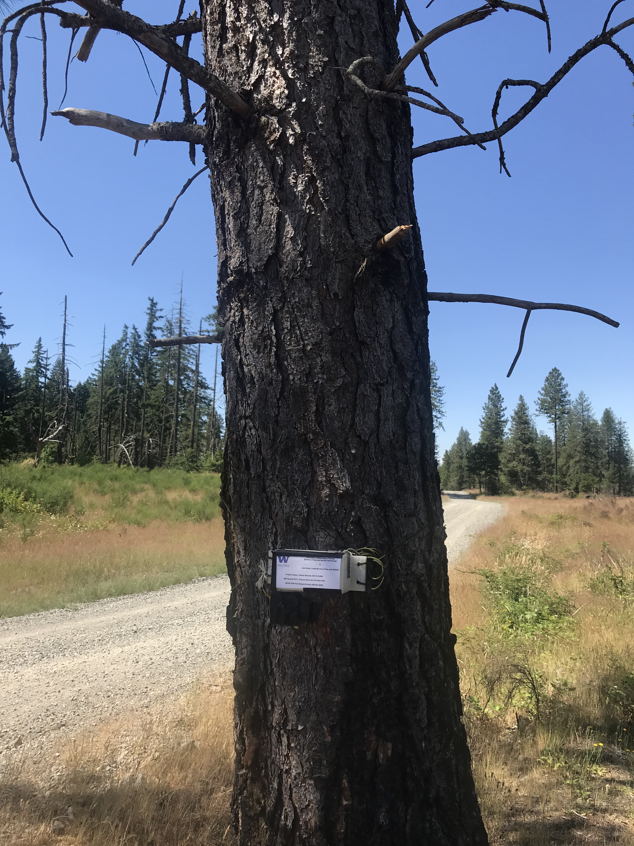
Pics/IMG_2359.jpg
