stevexenios/TreePower/Pics/IMG_2360.jpg

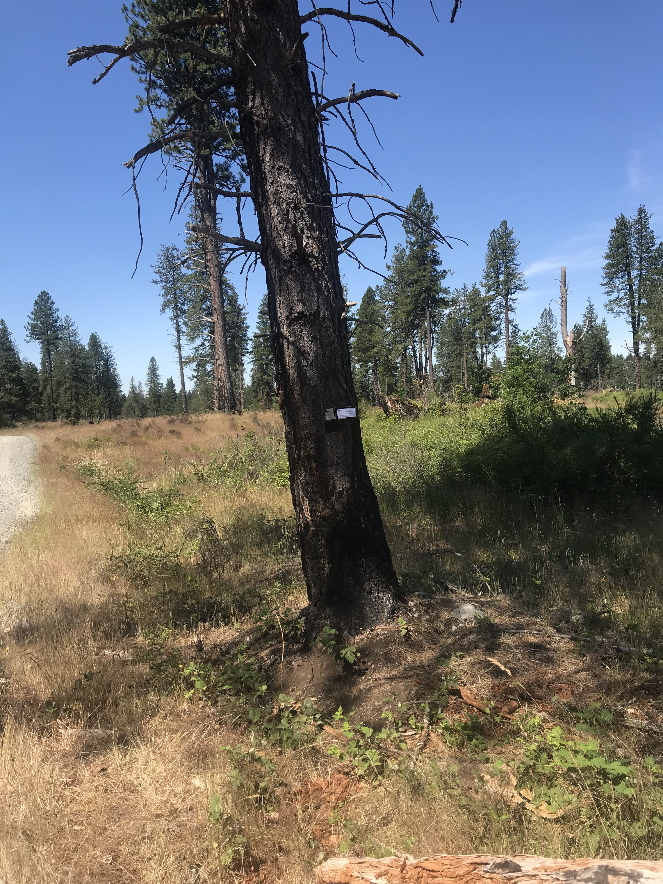
Pics/IMG_2360.jpg
