stevexenios/TreePower/Pics/IMG_2363.jpg

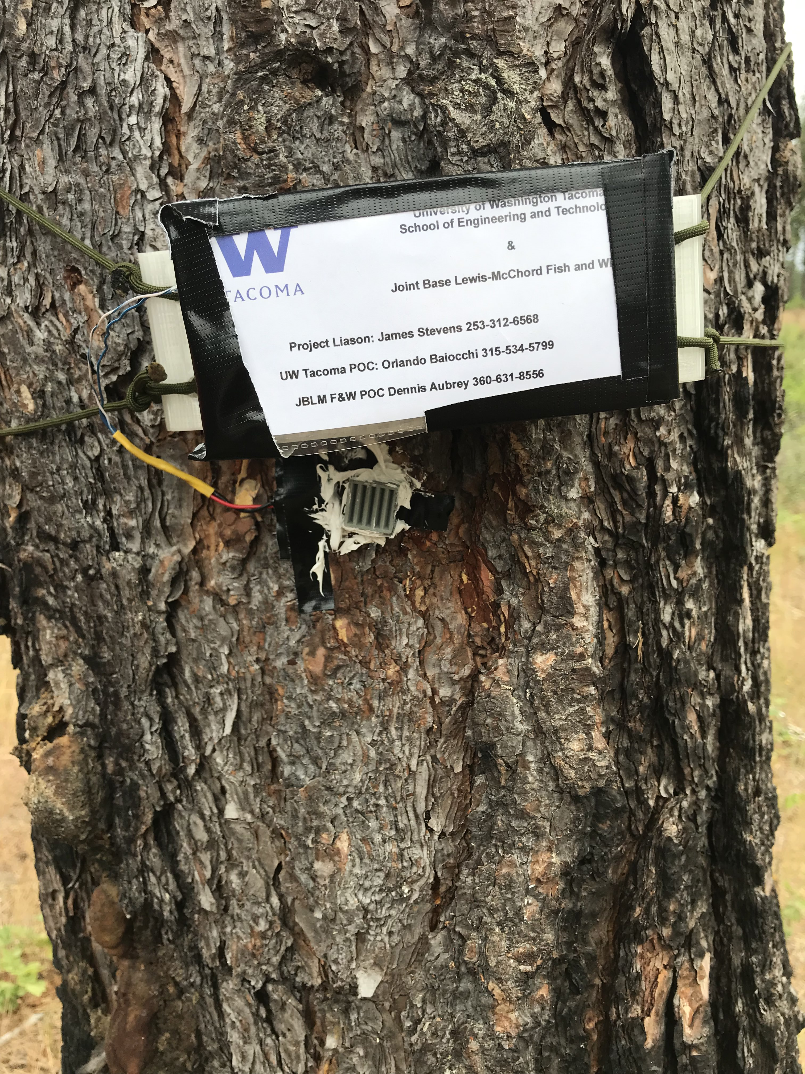
Pics/IMG_2363.jpg
