stevexenios/TreePower/Pics/IMG_2364.jpg

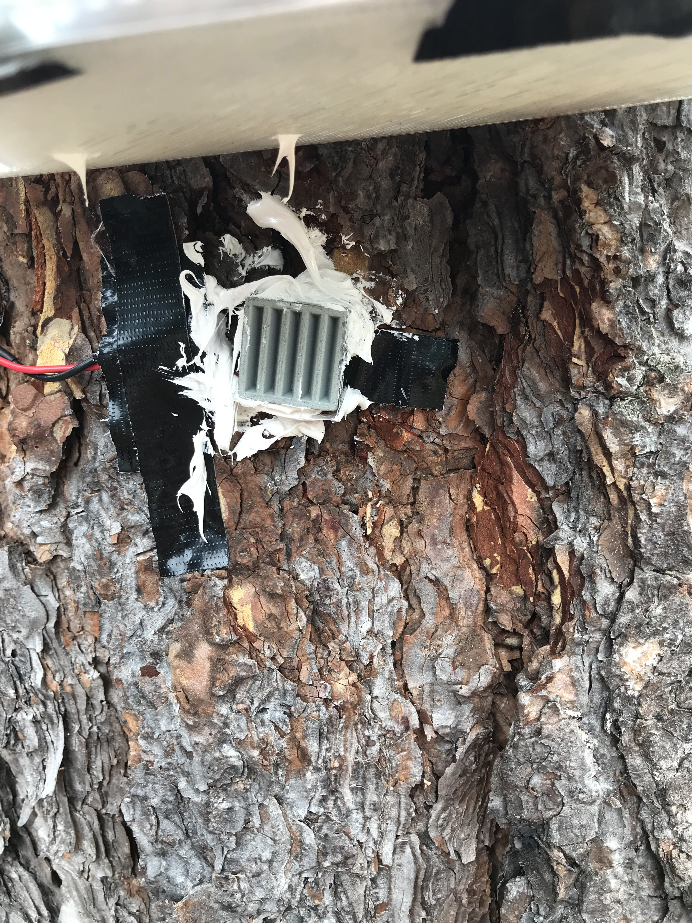
Pics/IMG_2364.jpg
