stevexenios/TreePower/Pics/IMG_2365.jpg

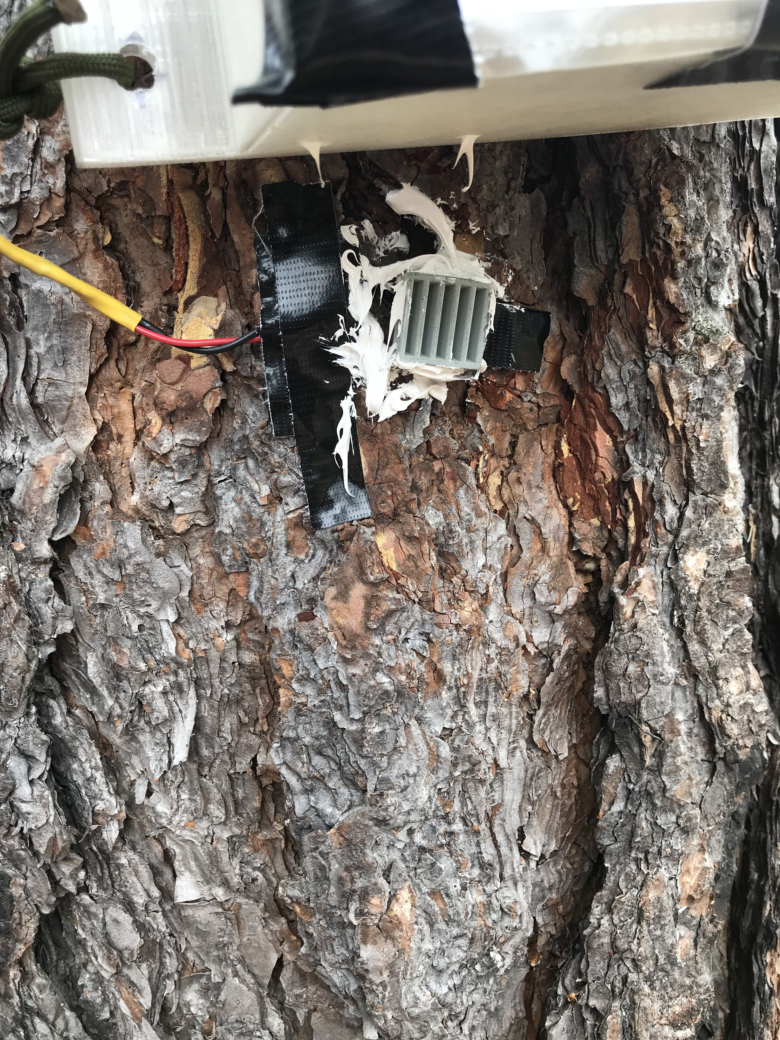
Pics/IMG_2365.jpg
