stevexenios/TreePower/Pics/IMG_2366.jpg

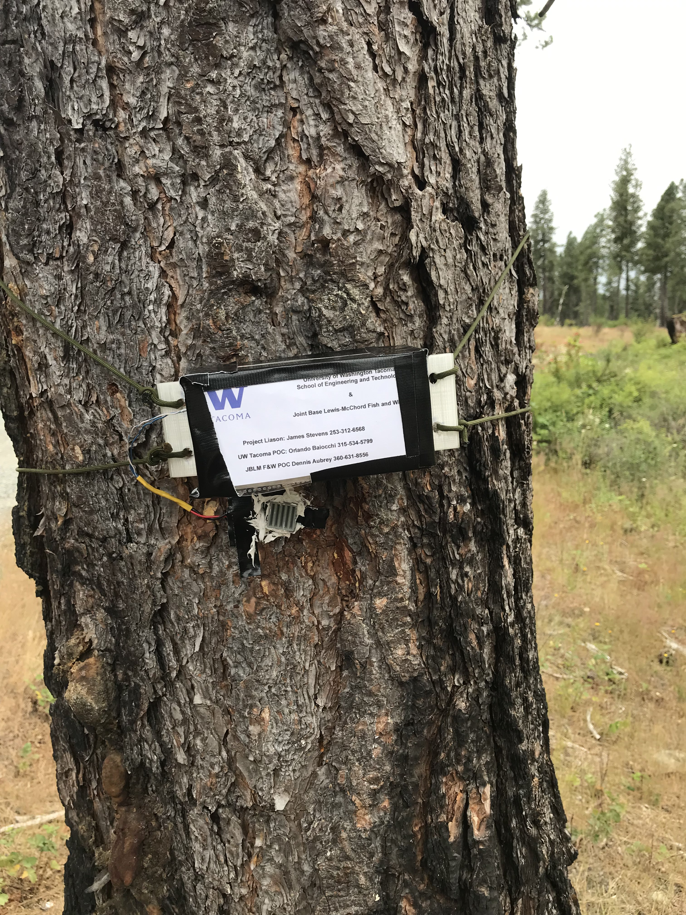
Pics/IMG_2366.jpg
