stevexenios/TreePower/Pics/IMG_2497.jpg

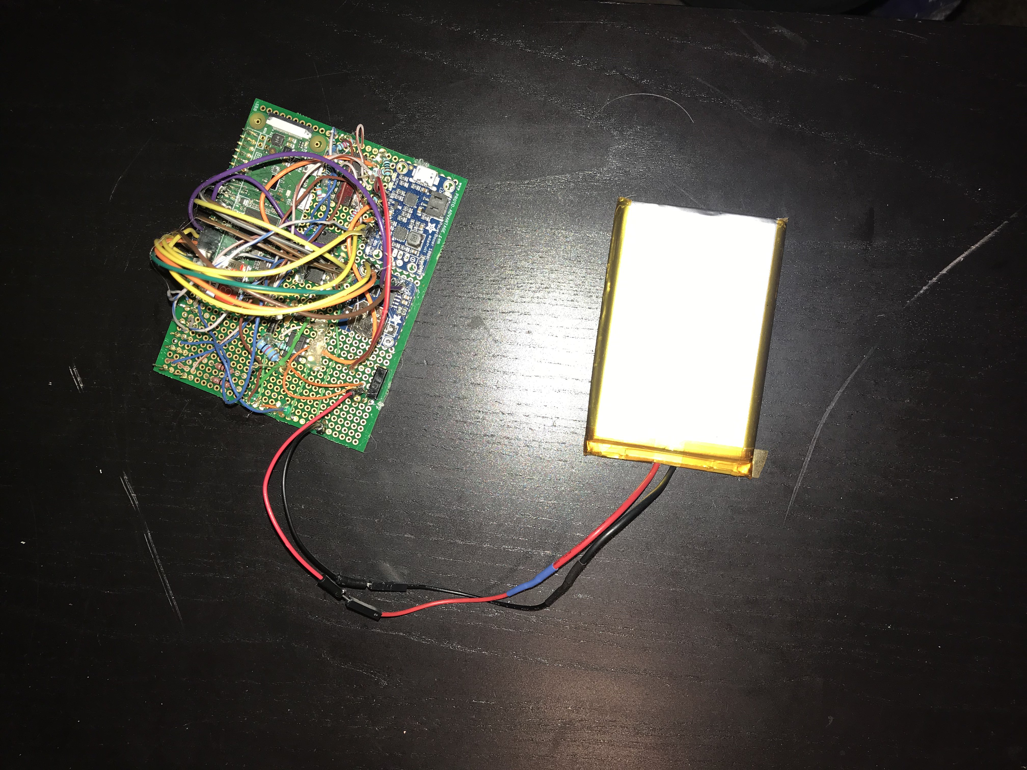
Pics/IMG_2497.jpg
