stevexenios/TreePower/Pics/IMG_2498.jpg

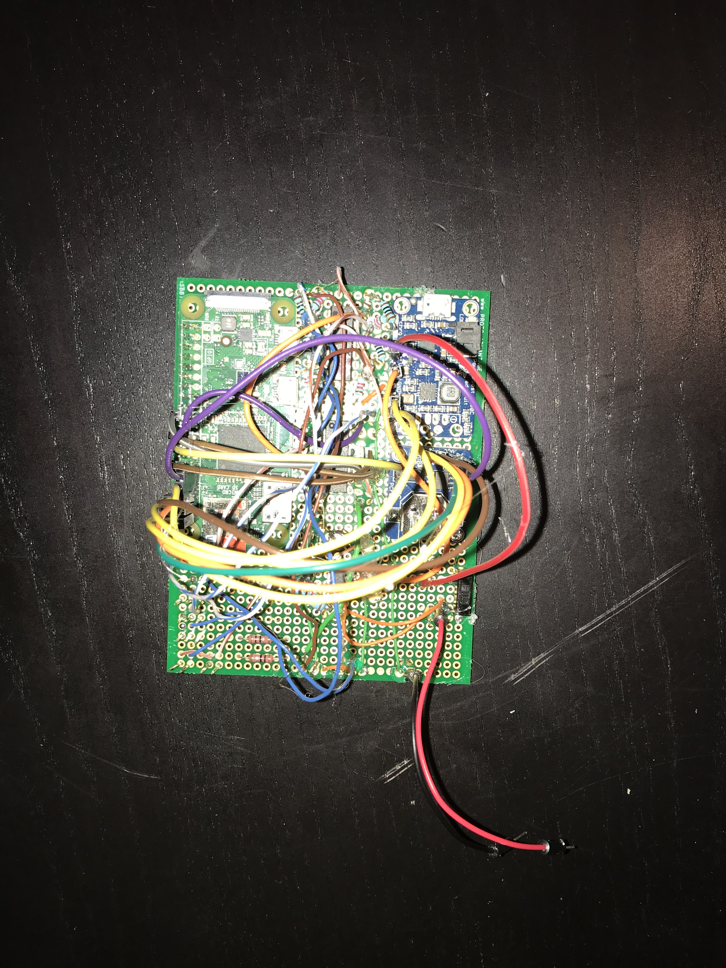
Pics/IMG_2498.jpg
