stevexenios/TreePower/Pics/IMG_2500.jpg

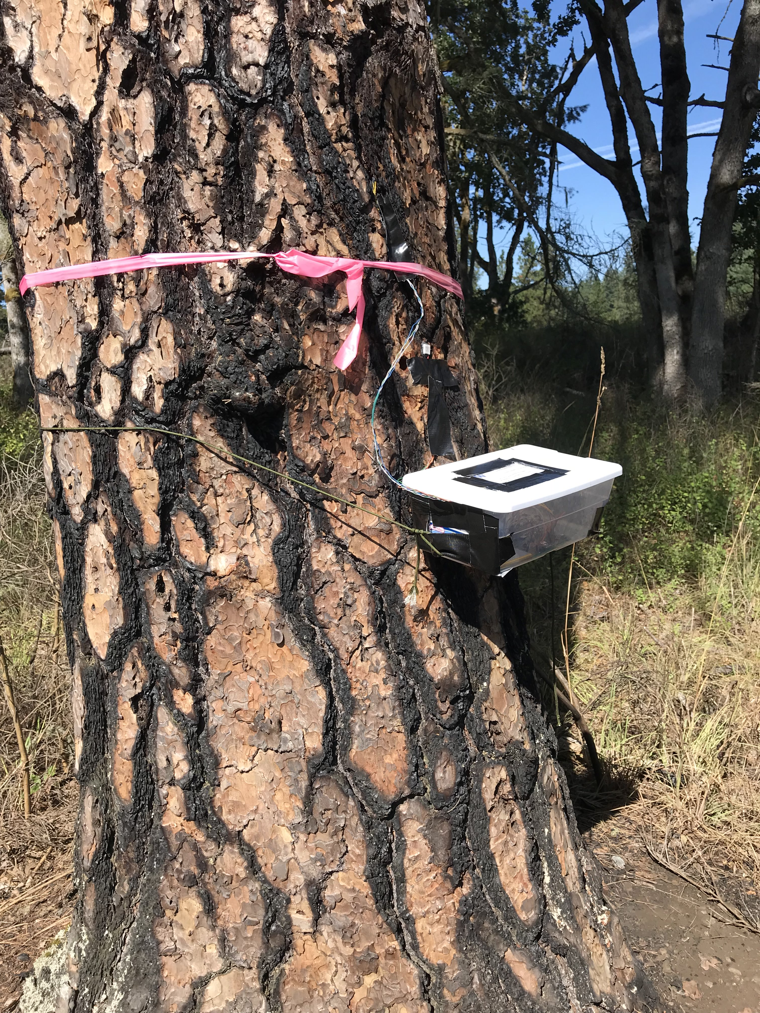
Pics/IMG_2500.jpg
