stevexenios/TreePower/Pics/IMG_2504.jpg

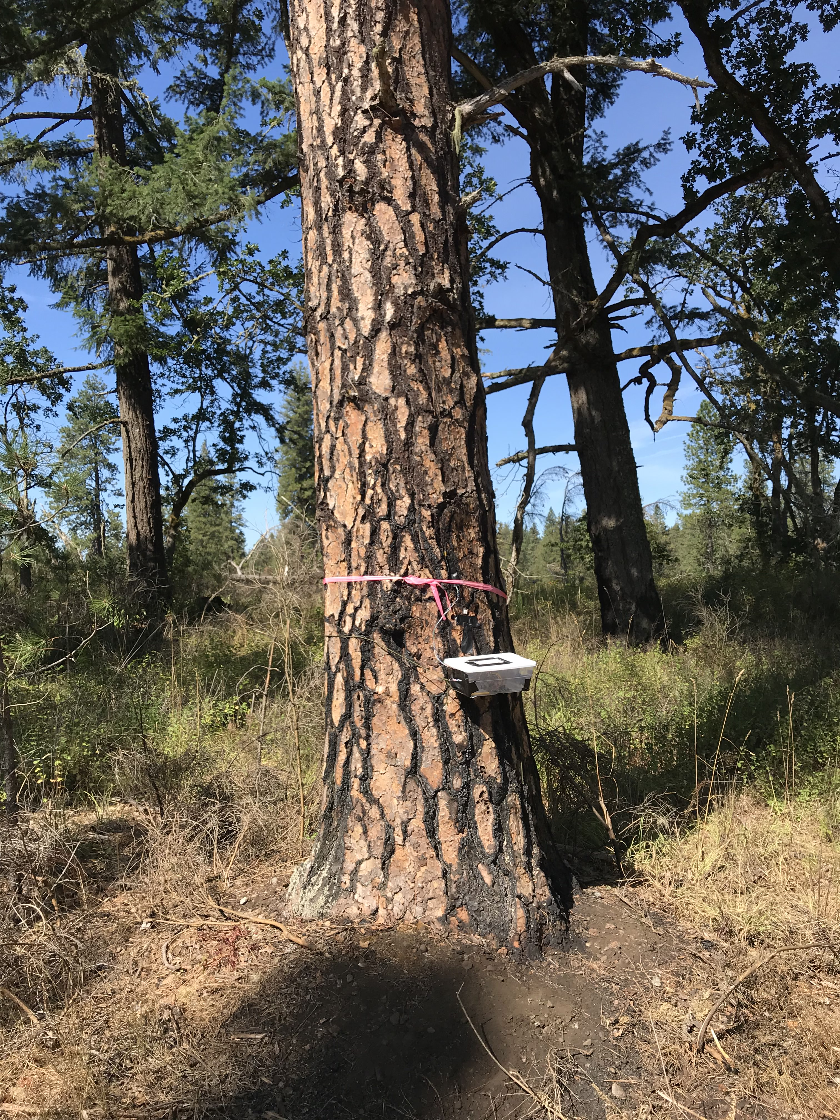
Pics/IMG_2504.jpg
