stevexenios/TreePower/Experiment1/Pic3.jpg

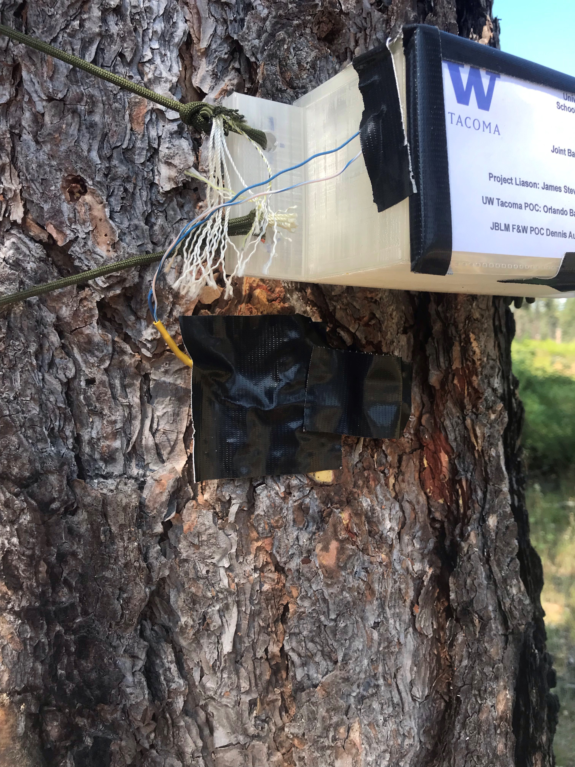
Experiment1/Pic3.jpg
