stevexenios/TreePower/Experiment1/Pic2.jpg

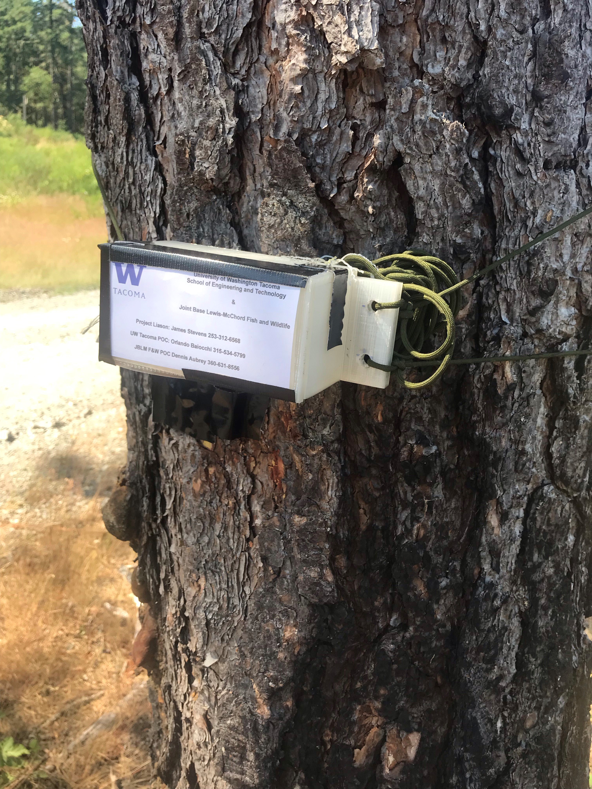
Experiment1/Pic2.jpg
